ben-hawks/AIV_DC31_Badge/DC31 Production/bom.csv

Designator | Footprint | Quantity | Value | LCSC Part #
BT1 | BAT_BC2AAAPC | 1 | BC2AAAPC
BZ1 | Buzzer_CUI_CPT-9019S-SMT | 1 | Buzzer | C968734
C1 | 805 | 1 | 100nF
C10 | 805 | 1 | 1uF/50V
C11 | 805 | 1 | 4.7uF/50V
C12 | 805 | 1 | 1uF/50V
C13 | 805 | 1 | 10uf
C14 | 805 | 1 | 1uF/50V
C15 | 805 | 1 | 47uF
C16 | 805 | 1 | 10uf
C17 | 805 | 1 | 10uf
C18 | 805 | 1 | 10uf
C19 | 805 | 1 | 10uf
C2 | 805 | 1 | 10uf
C20 | CAPAE660X630N | 1 | 47uF | C2161680
C3 | 805 | 1 | 10uF
C4 | 805 | 1 | 4.7uf/50V
C5 | 805 | 1 | 4.7uf/50V
C6 | 805 | 1 | 1uF/50V
C7 | 805 | 1 | 1uF/50V
C8 | 805 | 1 | 1uF/50V
C9 | 805 | 1 | 1uF/50V
D1, D2 | SOT-23 | 2 | 200mA/70V
D3, D4, D5, D6 | SOT95P237X111-3N | 4 | BAT54CLT1G
FPC1 | ER-CON24HT-1-REV | 1 | ER-CON24HT-1 | C11092
J1 | Badgelife-SAOv169-BADGE-2x3 | 1 | SAO_1
J10 | TF101AP3 | 1 | Micro_SD_Card | C266607
J2 | Badgelife-SAOv169-BADGE-2x3 | 1 | SAO_2
J3 | Badgelife-SAOv169-BADGE-2x3 | 1 | SAO_3
J4 | Badgelife-SAOv169-BADGE-2x3 | 1 | SAO_4
J5 | JST_SH_SM04B-SRSS-TB_1x04-1MP_P1.00mm_Horizontal | 1 | QWiic/STEMMA QT 1 | C160404
J6 | JST_SH_SM04B-SRSS-TB_1x04-1MP_P1.00mm_Horizontal | 1 | QWiic/STEMMA QT 2 | C160404
J7 | PinHeader_1x05_P2.00mm_Vertical | 1 | I2C Header/BG
J8 | JST_SH_SM03B-SRSS-TB_1x03-1MP_P1.00mm_Horizontal | 1 | RPi SWD (JST-SH) | C160403
J9 | PinHeader_1x03_P2.00mm_Vertical | 1 | RPi SWD
JP1 | SolderJumper-2_P1.3mm_Open_RoundedPad1.0x1.5mm | 1 | SAO1_GPIO0
JP2 | SolderJumper-2_P1.3mm_Open_RoundedPad1.0x1.5mm | 1 | SAO1_GPIO1
JP3 | SolderJumper-3_P1.3mm_Bridged12_RoundedPad1.0x1.5mm | 1 | SolderJumper_3_Bridged12
L1 | L_Taiyo-Yuden_NR-40xx_HandSoldering | 1 | 10uH NRS4018T100MDGJ | C222882
LED1 | 1206 | 1 | BLUE
Q1, Q2, Q4 | SOT-23 | 3 | DMG2301L
Q3 | SOT-23 | 1 | DMN3731U-7 | C459540
Q5 | SOT-323_SC-70 | 1 | BSS138PW
R1 | 805 | 1 | 120k
R10 | 805 | 1 | 100
R11 | 805 | 1 | 100
R2 | 805 | 1 | 10k
R3 | 805 | 1 | 10k
R4 | 805 | 1 | 120k
R5 | 805 | 1 | 1k
R6 | 805 | 1 | 120k
R7 | 805 | 1 | 10k
R8 | 603 | 1 | 0.47 | C175657
R9 | 805 | 1 | 620k
S1_A1, S2_B1, S3_C1, S4_UP1, S5_DWN1, S6_RST1 | KMR442NGLFS_CNK | 6 | KMR442NGLFS | C221692
SW_BRD_PWR1, SW_SAO_PWR1 | SW-SMD_G-SWITCH_MK-12C02-G015 | 2 | SW_SPDT | C2911519
U1 | SOP65P490X110-8N | 1 | PCF85063ATT | C165608
U2 | MODULE_SC0918 | 1 | SC0918
U3, U4, U5 | SOT-89-3 | 3 | WL9005P3-33 | C2688248
Y1 | Crystal_SMD_3215-2Pin_3.2x1.5mm | 1 | SC32S-7PF20PPM | C2650468
