ben-hawks/AIV_DC31_Badge/art/aiv_badge_art_100mm_outline.dxf

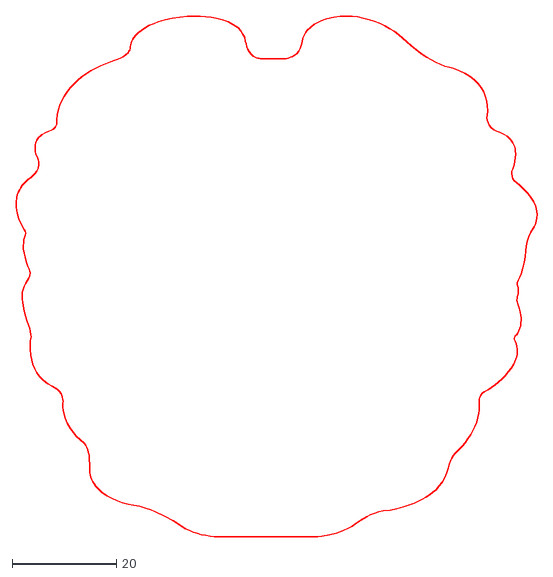
[picture p1: CAD file, 2024-05-24]
art/aiv_badge_art_100mm_outline.dxf
100.0 x 100.0
