ben-hawks/AIV_DC31_Badge/AIV_DC31_Staff.kicad_pcb

## KiCad design AIV_DC31_Staff.kicad_pcb (2024-05-24)

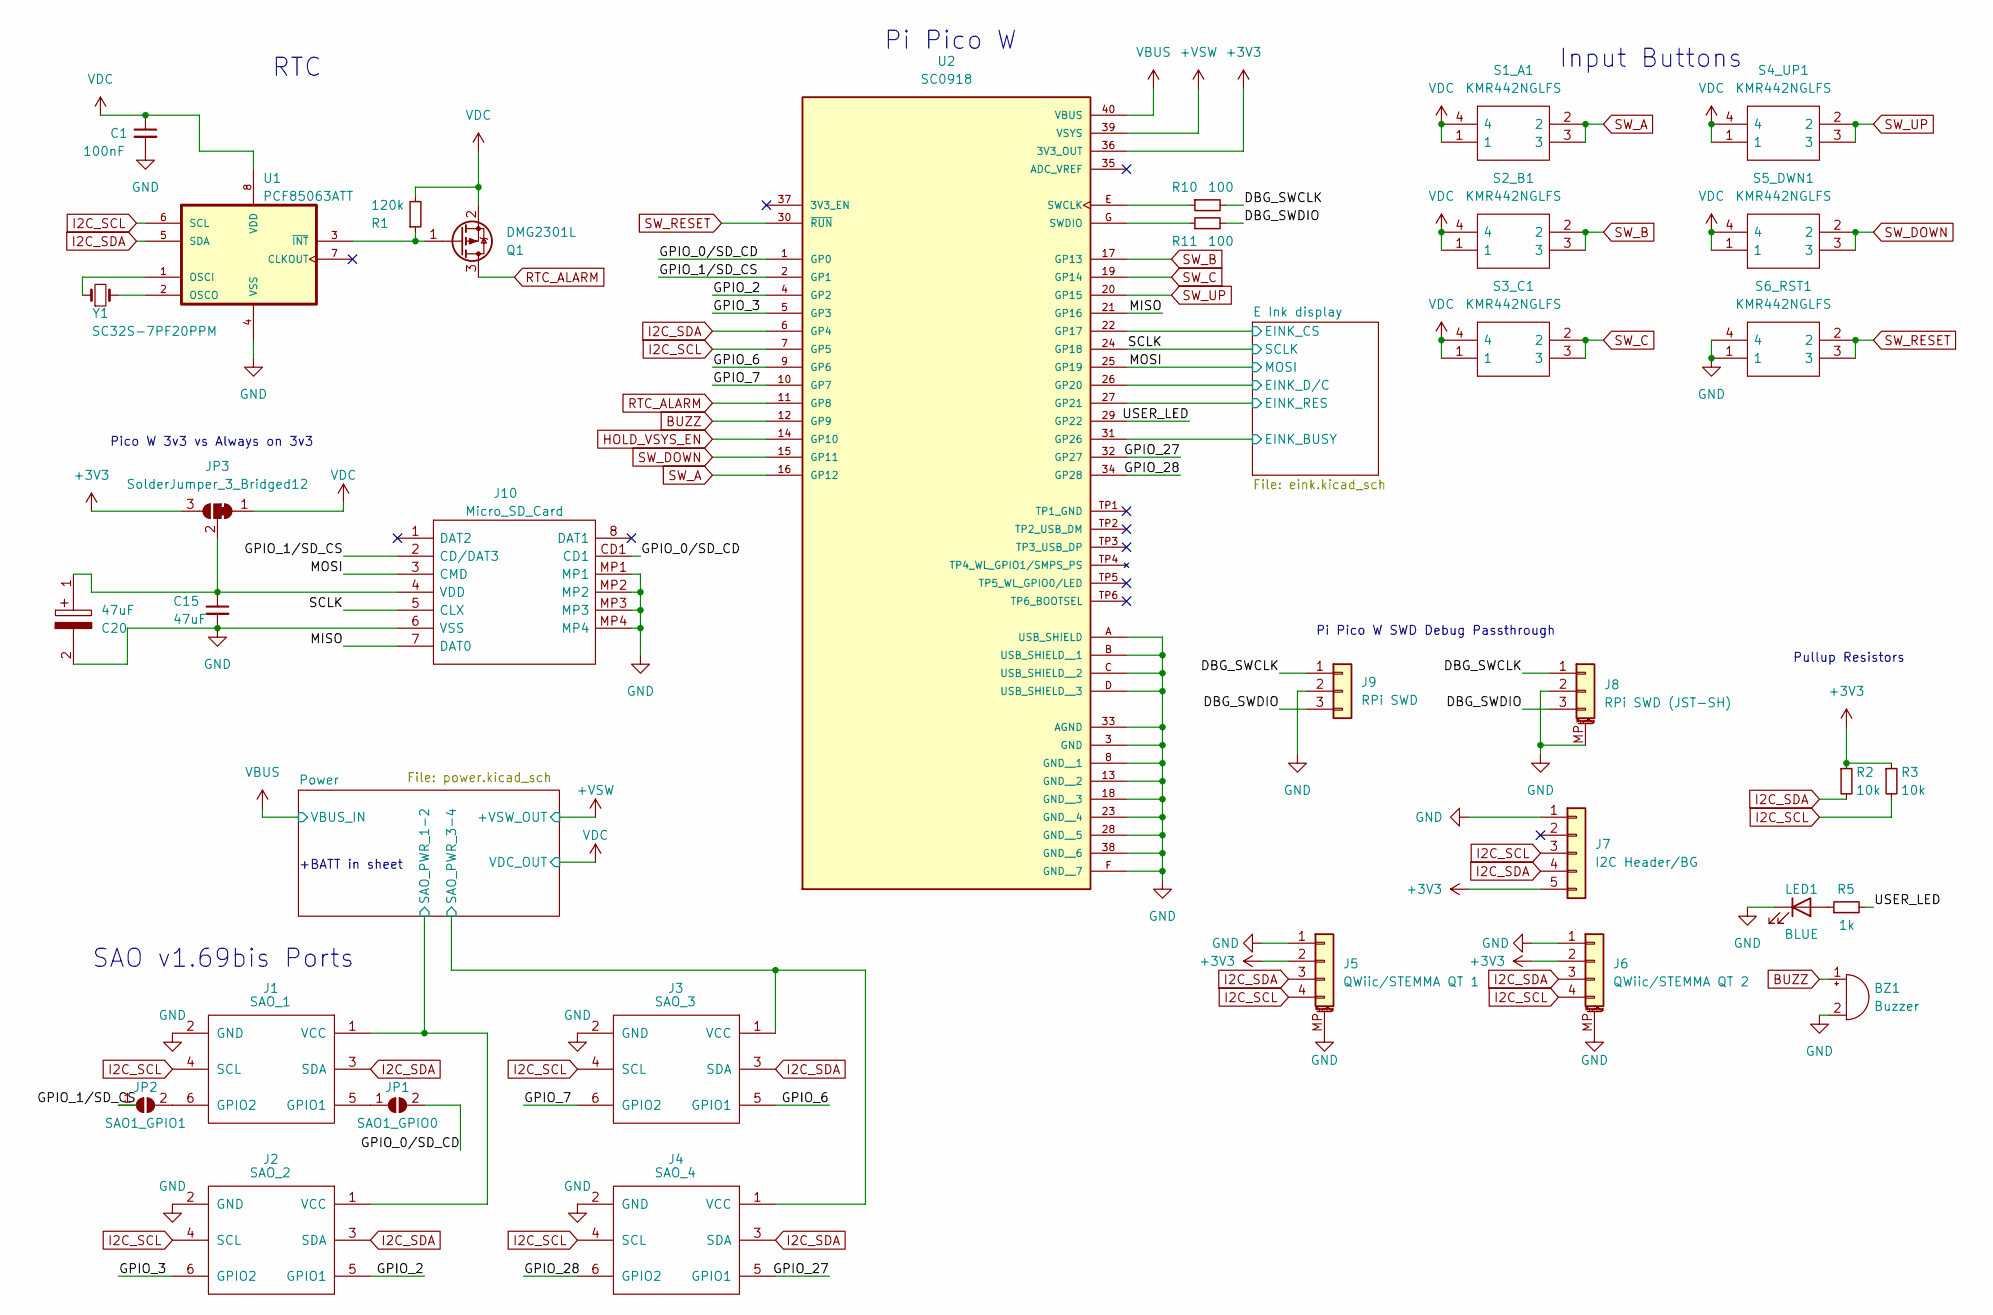
[picture p2: schematic AIV_DC31_Staff.kicad_sch]

Parts:
BZ1: Buzzer; Buzzer_CUI_CPT-9019S-SMT
C1: 100nF; C_0805_2012Metric_Pad1.18x1.45mm_HandSolder
C15: 47uF; C_0805_2012Metric_Pad1.18x1.45mm_HandSolder
C20: 47uF; CAPAE660X630N; Mouser Part Number 661-HHXC250A470MF61G
J1: SAO_1; Badgelife-SAOv169-BADGE-2x3
J2: SAO_2; Badgelife-SAOv169-BADGE-2x3
J3: SAO_3; Badgelife-SAOv169-BADGE-2x3
J4: SAO_4; Badgelife-SAOv169-BADGE-2x3
J5: QWiic/STEMMA QT 1; JST_SH_SM04B-SRSS-TB_1x04-1MP_P1.00mm_Horizontal; Part Number SM04B-SRSS-TB(LF)(SN)
J6: QWiic/STEMMA QT 2; JST_SH_SM04B-SRSS-TB_1x04-1MP_P1.00mm_Horizontal; Part Number SM04B-SRSS-TB(LF)(SN)
J7: I2C Header/BG; PinHeader_1x05_P2.00mm_Vertical
J8: RPi SWD (JST-SH); JST_SH_SM03B-SRSS-TB_1x03-1MP_P1.00mm_Horizontal
J9: RPi SWD; PinHeader_1x03_P2.00mm_Vertical
J10: Micro_SD_Card; TF101AP3; Manufacturer_Part_Number TF-101A-P3
JP1: SAO1_GPIO0; SolderJumper-2_P1.3mm_Open_RoundedPad1.0x1.5mm
JP2: SAO1_GPIO1; SolderJumper-2_P1.3mm_Open_RoundedPad1.0x1.5mm
JP3: SolderJumper_3_Bridged12; SolderJumper-3_P1.3mm_Bridged12_RoundedPad1.0x1.5mm
LED1: BLUE; LED_1206_3216Metric_Pad1.42x1.75mm_HandSolder
Q1: DMG2301L; SOT-23
R1: 120k; R_0805_2012Metric_Pad1.20x1.40mm_HandSolder
R2, R3: 10k; R_0805_2012Metric_Pad1.20x1.40mm_HandSolder
R5: 1k; R_0805_2012Metric_Pad1.20x1.40mm_HandSolder
R10, R11: 100; R_0805_2012Metric_Pad1.20x1.40mm_HandSolder
S1_A1, S2_B1, S3_C1, S4_UP1, S5_DWN1, S6_RST1: KMR442NGLFS; KMR442NGLFS_CNK; Mouser Part Number 611-KMR442NGLFS
U1: PCF85063ATT; SOP65P490X110-8N
U2: SC0918; MODULE_SC0918; PARTREV 2.1
Y1: SC32S-7PF20PPM; Crystal_SMD_3215-2Pin_3.2x1.5mm

Connections:
+3V3: J5.2, J6.2, J7.5, JP3.3 (B), R2.1, R3.1, U2.36 (3V3_OUT); also elsewhere on the board
+VSW: U2.39 (VSYS); also elsewhere on the board
/DBG_SWCLK: J8.1, J9.1, R10.2
/DBG_SWDIO: J8.3, J9.3, R11.2
/E Ink display/EINK_BUSY: U2.31 (GP26); also elsewhere on the board
/E Ink display/EINK_CS: U2.22 (GP17); also elsewhere on the board
/E Ink display/EINK_D/C: U2.26 (GP20); also elsewhere on the board
/E Ink display/EINK_RES: U2.27 (GP21); also elsewhere on the board
/GPIO_0/SD_CD: J10.CD1, JP1.2 (B), U2.1 (GP0)
/GPIO_1/SD_CS: J10.2 (CD/DAT3), JP2.1 (A), U2.2 (GP1)
/GPIO_2: J2.5 (GPIO1), U2.4 (GP2)
/GPIO_3: J2.6 (GPIO2), U2.5 (GP3)
/GPIO_6: J3.5 (GPIO1), U2.9 (GP6)
/GPIO_7: J3.6 (GPIO2), U2.10 (GP7)
/GPIO_27: J4.5 (GPIO1), U2.32 (GP27)
/GPIO_28: J4.6 (GPIO2), U2.34 (GP28)
/MISO: J10.7 (DAT0), U2.21 (GP16)
/MOSI: J10.3 (CMD), U2.25 (GP19); also elsewhere on the board
/Power/SAO_PWR_1-2: J1.1 (VCC), J2.1 (VCC); also elsewhere on the board
/Power/SAO_PWR_3-4: J3.1 (VCC), J4.1 (VCC); also elsewhere on the board
/SCLK: J10.5 (CLX), U2.24 (GP18); also elsewhere on the board
/USER_LED: R5.2, U2.29 (GP22)
BUZZ: BZ1.1 (-), U2.12 (GP9)
GND: BZ1.2 (+), C1.2, C15.2, C20.2, J1.2 (GND), J2.2 (GND), J3.2 (GND), J4.2 (GND), J5.1, J5.MP (MountPin), J6.1, J6.MP (MountPin), J7.1, J8.2, J8.MP (MountPin), J9.2, J10.6 (VSS), J10.MP1, J10.MP2, J10.MP3, J10.MP4, LED1.1 (K), S6_RST1.1, S6_RST1.4, U1.4 (VSS), U2.3 (GND), U2.8 (GND__1), U2.13 (GND__2), U2.18 (GND__3), U2.23 (GND__4), U2.28 (GND__5), U2.33 (AGND), U2.38 (GND__6), U2.A (USB_SHIELD), U2.B (USB_SHIELD__1), U2.C (USB_SHIELD__2), U2.D (USB_SHIELD__3), U2.F (GND__7); also elsewhere on the board
HOLD_VSYS_EN: U2.14 (GP10); also elsewhere on the board
I2C_SCL: J1.4 (SCL), J2.4 (SCL), J3.4 (SCL), J4.4 (SCL), J5.4, J6.4, J7.3, R3.2, U1.6 (SCL), U2.7 (GP5)
I2C_SDA: J1.3 (SDA), J2.3 (SDA), J3.3 (SDA), J4.3 (SDA), J5.3, J6.3, J7.4, R2.2, U1.5 (SDA), U2.6 (GP4)
unnamed: C15.1, C20.1, J10.4 (VDD), JP3.2 (C)
unnamed: J1.5 (GPIO1), JP1.1 (A)
unnamed: J1.6 (GPIO2), JP2.2 (B)
unnamed: LED1.2 (A), R5.1
unnamed: Q1.1 (G), R1.1, U1.3 (~INT)
unnamed: R10.1, U2.E (SWCLK)
unnamed: R11.1, U2.G (SWDIO)
unnamed: U1.1 (OSCI), Y1.1
unnamed: U1.2 (OSCO), Y1.2
RTC_ALARM: Q1.3 (D), U2.11 (GP8); also elsewhere on the board
SW_A: S1_A1.2, S1_A1.3, U2.16 (GP12); also elsewhere on the board
SW_B: S2_B1.2, S2_B1.3, U2.17 (GP13); also elsewhere on the board
SW_C: S3_C1.2, S3_C1.3, U2.19 (GP14); also elsewhere on the board
SW_DOWN: S5_DWN1.2, S5_DWN1.3, U2.15 (GP11); also elsewhere on the board
SW_RESET: S6_RST1.2, S6_RST1.3, U2.30 (~RUN)
SW_UP: S4_UP1.2, S4_UP1.3, U2.20 (GP15); also elsewhere on the board
VBUS: U2.40 (VBUS); also elsewhere on the board
VDC: C1.1, JP3.1 (A), Q1.2 (S), R1.2, S1_A1.1, S1_A1.4, S2_B1.1, S2_B1.4, S3_C1.1, S3_C1.4, S4_UP1.1, S4_UP1.4, S5_DWN1.1, S5_DWN1.4, U1.8 (VDD); also elsewhere on the board

Notes on the sheet:
RTC
SAO v1.69bis Ports
Pullup Resistors
+BATT in sheet
Input Buttons
Pico W 3v3 vs Always on 3v3
Pi Pico W
Pi Pico W SWD Debug Passthrough

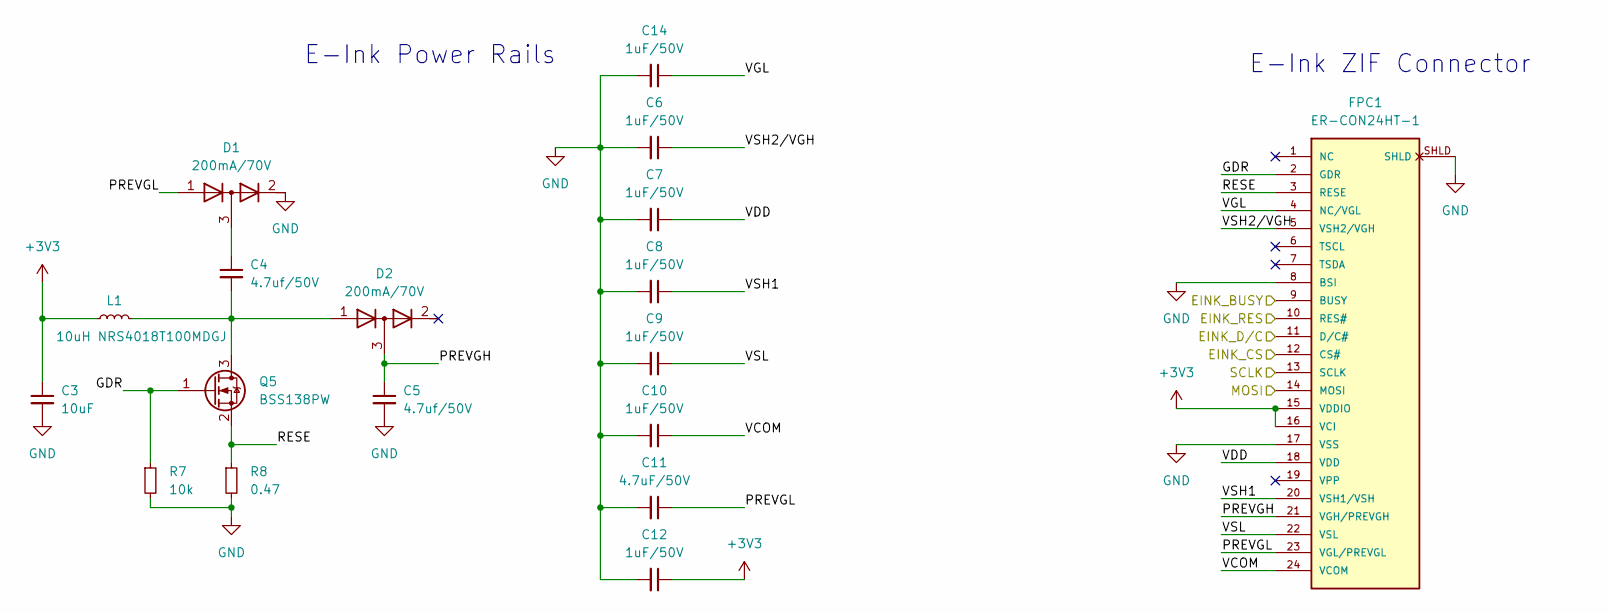
[picture p3: schematic eink.kicad_sch]

Parts:
C3: 10uF; C_0805_2012Metric_Pad1.18x1.45mm_HandSolder
C4, C5: 4.7uf/50V; C_0805_2012Metric_Pad1.18x1.45mm_HandSolder
C6, C7, C8, C9, C10, C12, C14: 1uF/50V; C_0805_2012Metric_Pad1.18x1.45mm_HandSolder
C11: 4.7uF/50V; C_0805_2012Metric_Pad1.18x1.45mm_HandSolder
D1, D2: 200mA/70V; SOT-23
FPC1: ER-CON24HT-1; ER-CON24HT-1-REV
L1: 10uH NRS4018T100MDGJ; L_Taiyo-Yuden_NR-40xx_HandSoldering
Q5: BSS138PW; SOT-323_SC-70
R7: 10k; R_0805_2012Metric_Pad1.20x1.40mm_HandSolder
R8: 0.47; R_0603_1608Metric_Pad0.98x0.95mm_HandSolder

Connections:
+3V3: C3.1, C12.1, FPC1.15 (VDDIO), FPC1.16 (VCI), L1.1; also elsewhere on the board
/E Ink display/EINK_BUSY: FPC1.9 (BUSY); also elsewhere on the board
/E Ink display/EINK_CS: FPC1.12 (CS#); also elsewhere on the board
/E Ink display/EINK_D/C: FPC1.11 (D/C#); also elsewhere on the board
/E Ink display/EINK_RES: FPC1.10 (RES#); also elsewhere on the board
/E Ink display/GDR: FPC1.2 (GDR), Q5.1 (G), R7.1
/E Ink display/PREVGH: C5.1, D2.3 (common), FPC1.21 (VGH/PREVGH)
/E Ink display/PREVGL: C11.1, D1.1 (A), FPC1.23 (VGL/PREVGL)
/E Ink display/RESE: FPC1.3 (RESE), Q5.2 (S), R8.1
/E Ink display/VCOM: C10.1, FPC1.24 (VCOM)
/E Ink display/VDD: C7.1, FPC1.18 (VDD)
/E Ink display/VGL: C14.1, FPC1.4 (NC/VGL)
/E Ink display/VSH1: C8.1, FPC1.20 (VSH1/VSH)
/E Ink display/VSH2/VGH: C6.1, FPC1.5 (VSH2/VGH)
/E Ink display/VSL: C9.1, FPC1.22 (VSL)
/MOSI: FPC1.14 (MOSI); also elsewhere on the board
/SCLK: FPC1.13 (SCLK); also elsewhere on the board
GND: C3.2, C5.2, C6.2, C7.2, C8.2, C9.2, C10.2, C11.2, C12.2, C14.2, D1.2 (K), FPC1.8 (BSI), FPC1.17 (VSS), FPC1.SHLD, R7.2, R8.2; also elsewhere on the board
unnamed: C4.1, D1.3 (common)
unnamed: C4.2, D2.1 (A), L1.2, Q5.3 (D)

Notes on the sheet:
E-Ink Power Rails
E-Ink ZIF Connector

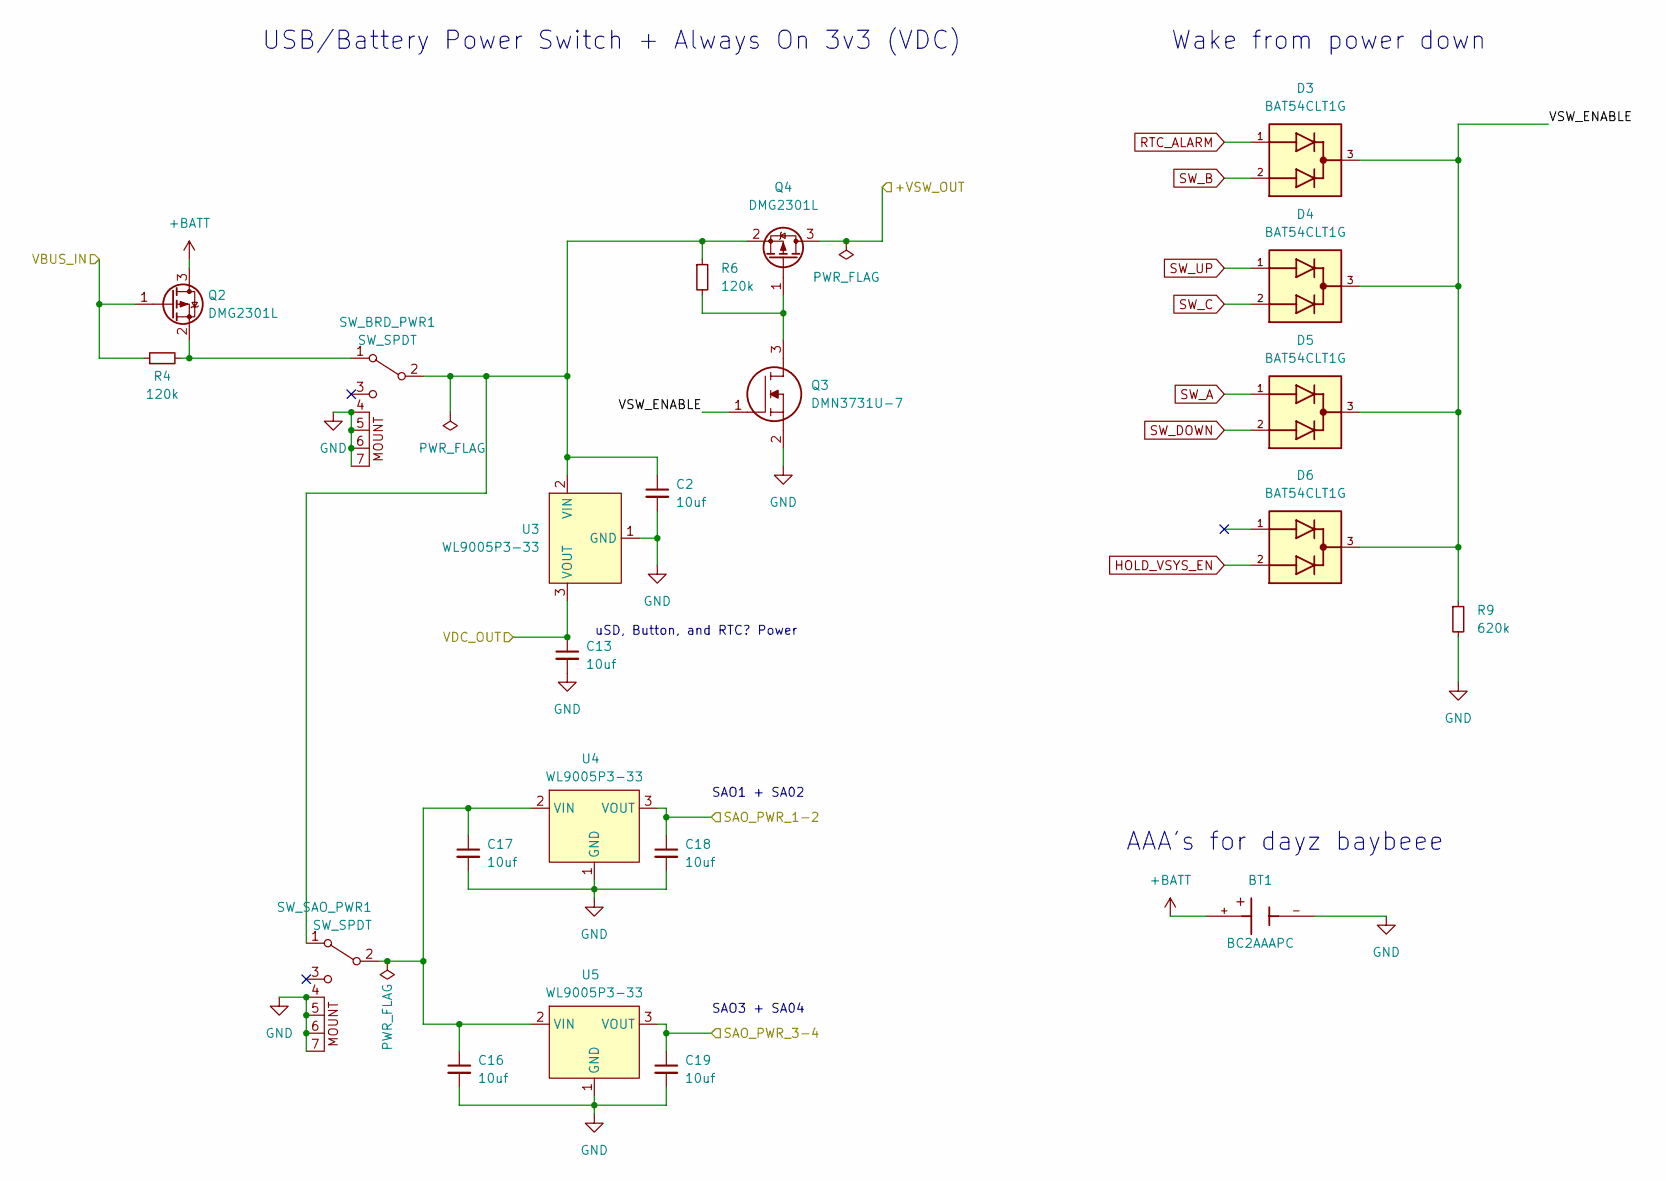
[picture p4: schematic power.kicad_sch]

Parts:
BT1: BC2AAAPC; BAT_BC2AAAPC; PARTREV L
C2, C13, C16, C17, C18, C19: 10uf; C_0805_2012Metric_Pad1.18x1.45mm_HandSolder
D3, D4, D5, D6: BAT54CLT1G; SOT95P237X111-3N; PARTREV 12
Q2, Q4: DMG2301L; SOT-23
Q3: DMN3731U-7; SOT-23; Manufacturer_Part_Number DMN3731U-7; Mouser Part Number 621-DMN3731U-7
R4, R6: 120k; R_0805_2012Metric_Pad1.20x1.40mm_HandSolder
R9: 620k; R_0805_2012Metric_Pad1.20x1.40mm_HandSolder
SW_BRD_PWR1: SW_SPDT; SW-SMD_G-SWITCH_MK-12C02-G015
SW_SAO_PWR1: SW_SPDT; SW-SMD_G-SWITCH_MK-12C02-G015
U3, U4, U5: WL9005P3-33; SOT-89-3

Connections:
+BATT: BT1.+, Q2.3 (D)
+VSW: Q4.3 (D); also elsewhere on the board
/Power/SAO_PWR_1-2: C18.1, U4.3 (VOUT); also elsewhere on the board
/Power/SAO_PWR_3-4: C19.1, U5.3 (VOUT); also elsewhere on the board
/Power/VSW_ENABLE: D3.3, D4.3, D5.3, D6.3, Q3.1, R9.1
GND: BT1.-, C2.2, C13.2, C16.2, C17.2, C18.2, C19.2, Q3.2, R9.2, SW_BRD_PWR1.4 (GND), SW_BRD_PWR1.5 (GND), SW_BRD_PWR1.6 (GND), SW_BRD_PWR1.7 (GND), SW_SAO_PWR1.4 (GND), SW_SAO_PWR1.5 (GND), SW_SAO_PWR1.6 (GND), SW_SAO_PWR1.7 (GND), U3.1 (GND), U4.1 (GND), U5.1 (GND); also elsewhere on the board
HOLD_VSYS_EN: D6.2; also elsewhere on the board
unnamed: C2.1, Q4.2 (S), R6.1, SW_BRD_PWR1.2 (B), SW_SAO_PWR1.1 (A), U3.2 (VIN)
unnamed: C16.1, C17.1, SW_SAO_PWR1.2 (B), U4.2 (VIN), U5.2 (VIN)
unnamed: Q2.2 (S), R4.2, SW_BRD_PWR1.1 (A)
unnamed: Q3.3, Q4.1 (G), R6.2
RTC_ALARM: D3.1; also elsewhere on the board
SW_A: D5.1; also elsewhere on the board
SW_B: D3.2; also elsewhere on the board
SW_C: D4.2; also elsewhere on the board
SW_DOWN: D5.2; also elsewhere on the board
SW_UP: D4.1; also elsewhere on the board
VBUS: Q2.1 (G), R4.1; also elsewhere on the board
VDC: C13.1, U3.3 (VOUT); also elsewhere on the board

Notes on the sheet:
Wake from power down
SAO1 + SA02
uSD, Button, and RTC? Power
USB/Battery Power Switch + Always On 3v3 (VDC)
AAA's for dayz baybeee
SAO3 + SA04

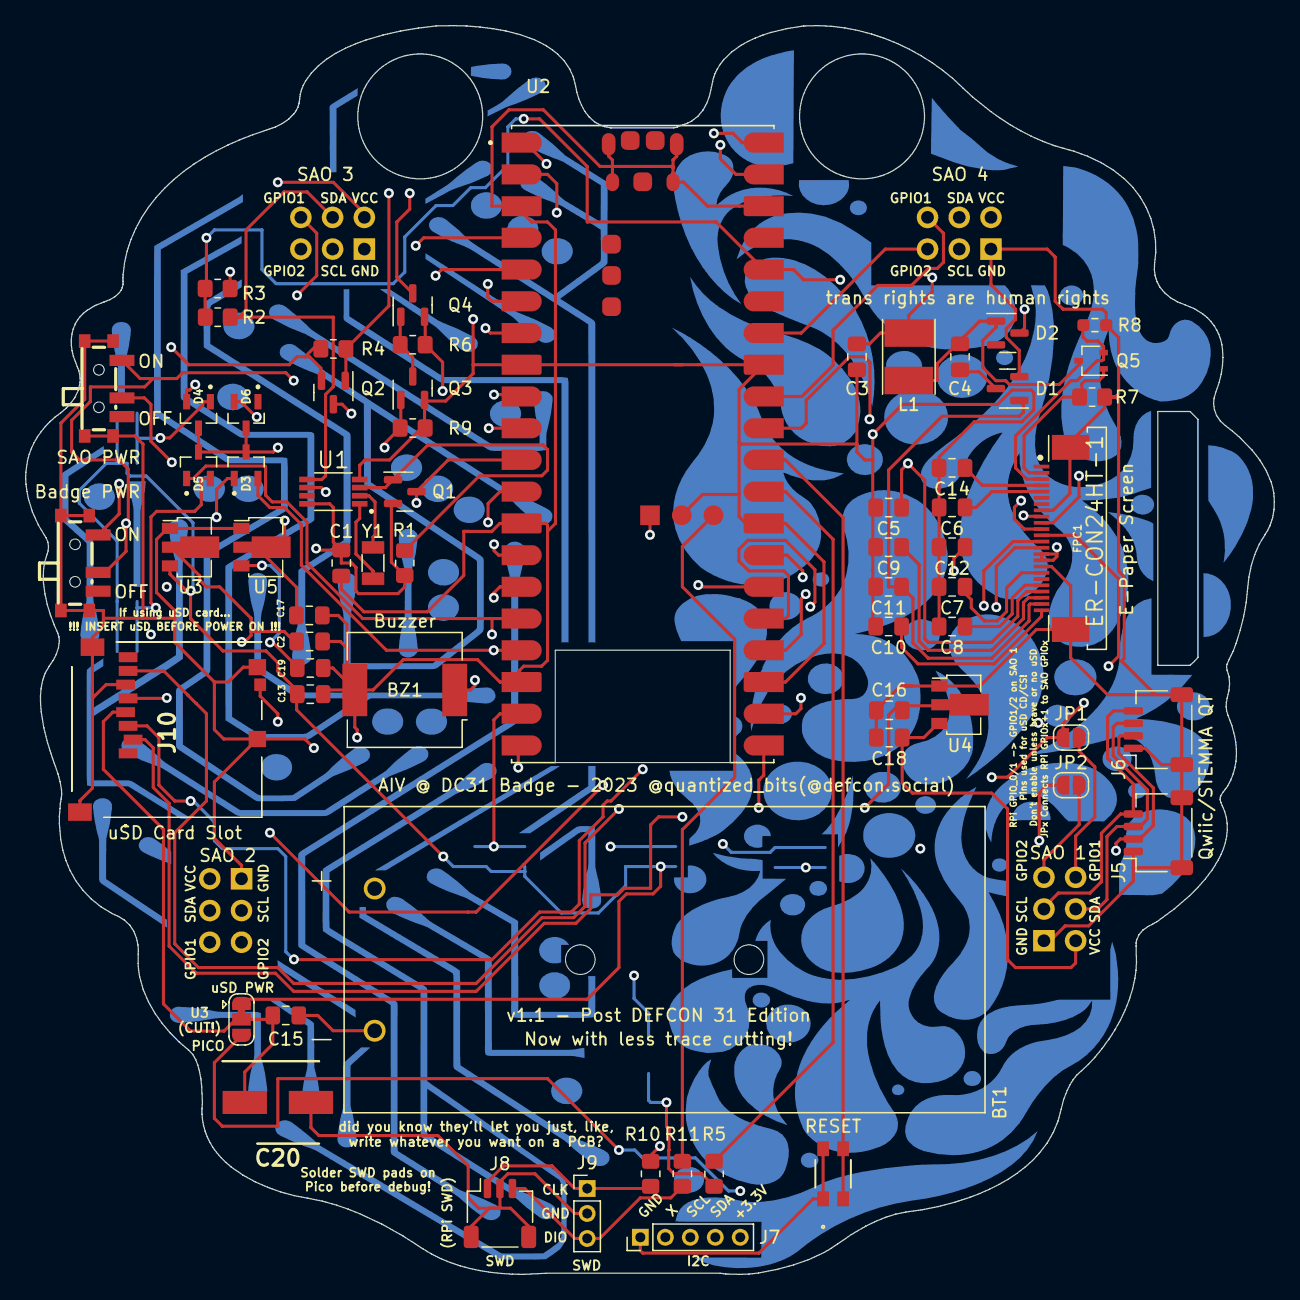
[picture p5: board AIV_DC31_Staff.kicad_pcb from above]

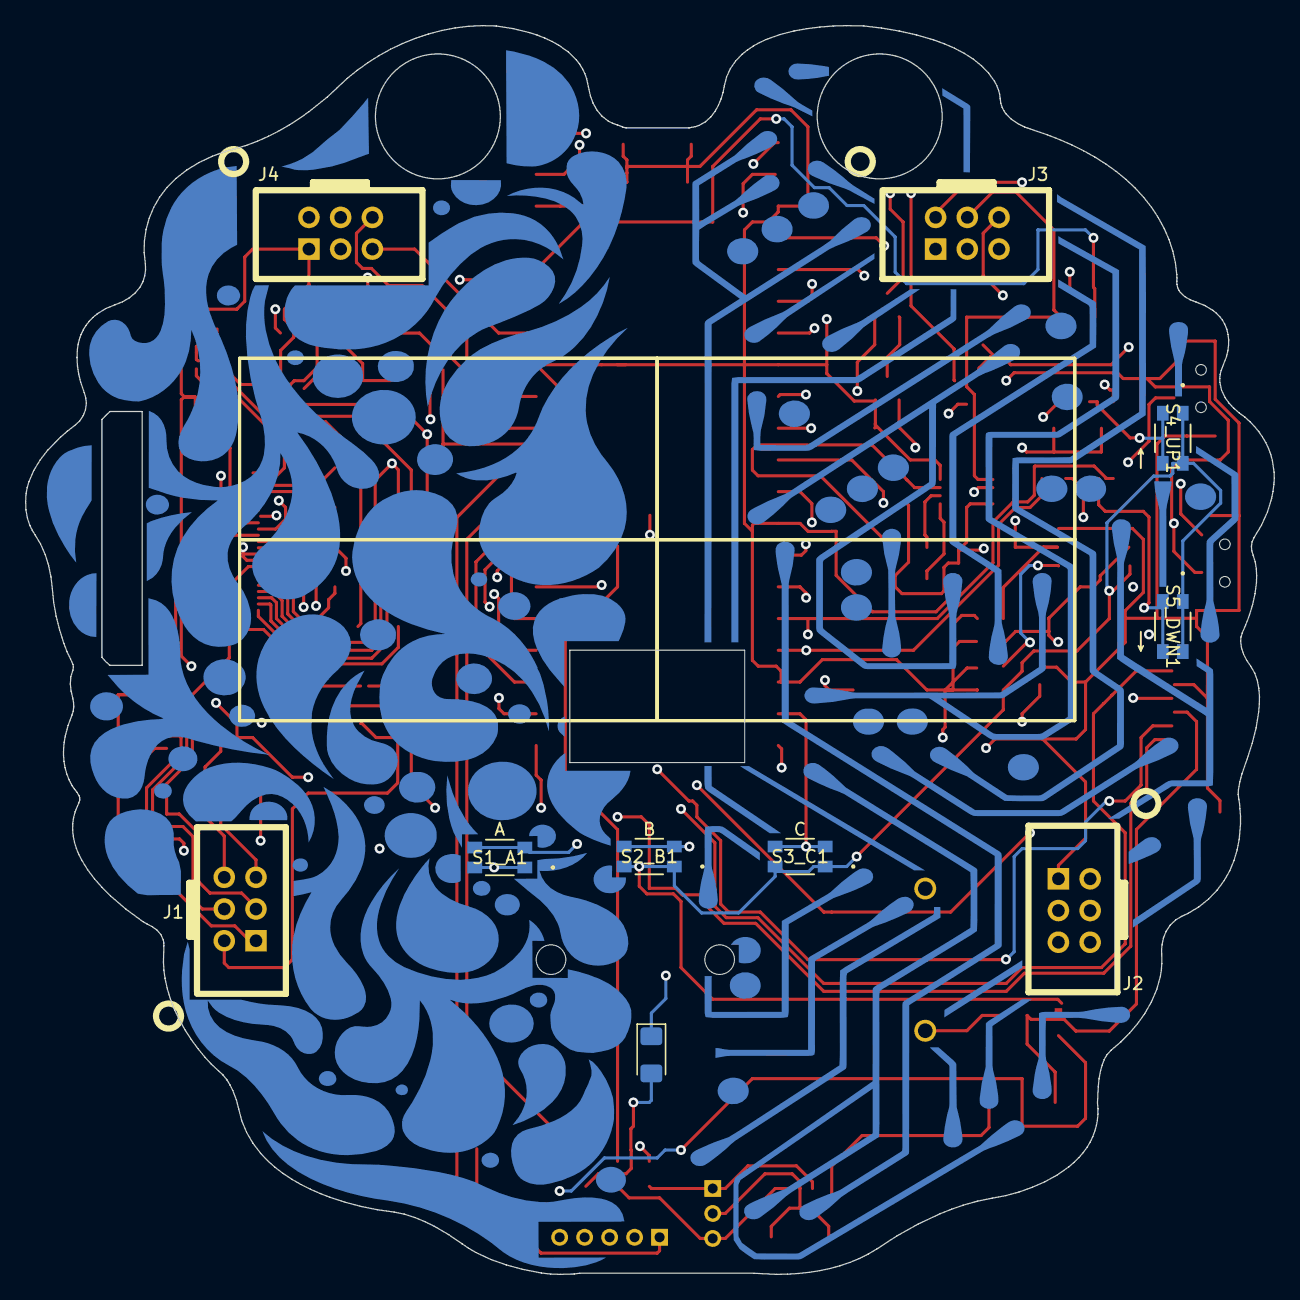
[picture p6: board AIV_DC31_Staff.kicad_pcb from below]

Board: 4 copper layers, 100.0 x 100.0 mm, 74 parts (10 on the bottom side), 63 nets.
