ben-hawks/AIV_DC31_Badge/(commit log)

2024-05-24 Initial Commit of AIV DC31 Badge Files
    [AIV_DC31_Staff.kicad_pcb, AIV_DC31_Staff.kicad_sch, aiv_badge_art_100mm_outline.dxf, eink.kicad_sch, power.kicad_sch]
2024-05-24 Add in missing BOM Files
    [bom.csv, designators.csv, positions.csv]
